etf-unibl/fpga-sonar/docs/rc-servo.md

# Hitec HS-422 Deluxe Standard Servo – Documentation

This document provides detailed information about the **Hitec HS-422 Deluxe Standard Servo**, renowned for its reliability, precision, and durable construction. The servo is widely used in RC models, robotics, and other applications requiring precise position control.

---

HS-422-Servo-Specs__93581
_Picture 1.1_ HS 422 Servo Specification

## 1. Key Characteristics

- **Operating Voltage:**  
  - Operates within a voltage range of **4.8V to 6.0V**, ensuring compatibility with most RC control systems.

- **Speed:**  
  - At **4.8V:** approximately **0.21 seconds/60°** of rotation.
  - At **6.0V:** speed improves to around **0.16 seconds/60°**.

- **Torque:**  
  - At **4.8V:** about **45.82 oz-in** (approximately 3.3 kg-cm).
  - At **6.0V:** up to approximately **56.93 oz-in** (around 4.1 kg-cm).

- **Control System:**  
  - **Analog PWM** – the servo is controlled via a PWM signal with a period of approximately **20 ms** (50 Hz).  
  - The typical operating PWM pulse width ranges between **600 µs** and **2400 µs** (with a center pulse of around 1500 µs).  
  - The servo features a very small **deadband** of about **8 µs**, ensuring high precision.

ser0002_3     
_Picture 1.2_ Shaft position depending on the PWM signal

- **Motor and Mechanical Construction:**  
  - **Motor:** A 3-pole metal brushed motor (often described as a "3-pole metal brush ferrite" motor).
  - **Gears:** Made from **nylon** (a high-efficiency resin gear train) to ensure longevity.
  - **Bearings:** Equipped with dual oilite (lubricated) bushings for excellent centering and stable output shaft performance.

- **Dimensions and Weight:**  
  - **Dimensions (Metric):** 40.6 mm (length) × 19.8 mm (width) × 36.6 mm (height)
  - **Weight:** Approximately **45.5 g** (1.6 oz)

---

## 2. Additional Information

- **Durability and Reliability:**  
  The HS-422 is known for its robust construction. Its dual oilite bushings and high-quality gear train design provide excellent centering and minimal deviation during movement, which is crucial for precise applications.

- **Applications:**  
  The HS-422 is used in:
  - RC models (airplanes, cars, helicopters)
  - Robotics
  - Any application requiring precise angular control and rapid response

- **Modification Options:**  
  With accessories such as a Servo Travel Tuner, the PWM signal range can be expanded, potentially increasing the rotation angle (up to approximately 195° in certain configurations).

- **Technical Documentation:**  
  Detailed datasheets and technical specifications are available from distributors such as DigiKey, RobotShop, ServoDatabase.com, Mr MPX Hobbies, and Sig Manufacturing.

---

zice        
_Picture 1.3_ Servo pinout

## 3. Summary

The **Hitec HS-422 Deluxe Standard Servo** is a reliable analog servo motor operating at **4.8V to 6.0V**, with speeds of **0.21/0.16 sec/60°** and torque ranging from approximately **45.82 oz-in to 56.93 oz-in**. Its robust construction featuring nylon gears, dual oilite bushings, and a 3-pole brushed motor makes it ideal for applications demanding high precision and durability. The servo is controlled via a PWM signal (typically with a 20 ms period) with a very narrow deadband (8 µs), enabling exceptional positional accuracy.

---

## 4. References

- [Servocity – HS-422 Servo-Clockwise (stock)](https://www.servocity.com/hs-422-servo/)
- [ServoDatabase – Hitec HS-422 Deluxe Standard Servo Specifications](https://servodatabase.com/servo/hitec/hs-422)
- [DigiKey HS-422 Servo Datasheet](https://media.digikey.com/pdf/data%20sheets/dfrobot%20pdfs/ser0002_web.pdf)
- [Mr MPX Hobbies – Hitec HS-422 Deluxe Standard Servo](https://mrmpxhobbies.com/product/hitec-hs-422-deluxe-standard-servo/)
- [Sig Manufacturing – HI TECH HS-422 STANDARD SERVO](https://sigmfg.com/products/hi-tech-hs-422-standard-servo)

---

This Markdown documentation provides a comprehensive overview of the Hitec HS-422 Deluxe Standard Servo and serves as a reference for technical and project needs.
