etf-unibl/fpga-sonar/(threads)

Thread 10 (2025-02-03):

Testing RC Servo

Neira7, 2025-02-03:
Potrebno je implementirati osnovni VHDL kod za testiranje RC Servo motora.
Testiranje odziva RC Servo motora na različite PWM signale.

Closed 2025-02-26.

Thread 2 (2025-02-03):

Get Familiar with VUnit Framework

knezicm, 2025-02-03:
The team members are expected to get familiar with the VUnit framework in order to be able to systematically and efficiently verify the design during the project lifetime. The initial instructions on how to setup and use the framework can be found in the link:

https://vunit.github.io/user_guide.html

By the end of the sprint, it is expected to have the following items so that the issue can be considered as completed:

- Documentation page with instructions on how to setup and use VUnit framework that can be used for on-boarding team members who have no experience with the framework. The page can be prepared in form of a Wiki page or as a standalone documentation page placed in the `doc` folder.
- Working example that shows how to integrate a design with corresponding testbench in the project. This example must be reviewed by at least one team member who has not participated in preparing the VUnit instructions and the working example. Moreover, the provided example must pass verification check available in the repository as a GitHub action

Closed 2025-02-17.

Thread 3 (2025-02-03):

Create Module for Controlling VGA Interface

knezicm, 2025-02-03:
Investigate how VGA interface works and create a basic VGA controller for drawing an object on monitor screen. Initial resources you can use to get familiar with the interface are provided on the links below:

https://www.youtube.com/watch?v=5exFKr-JJtg
https://digilent.com/reference/learn/programmable-logic/tutorials/vga-display-congroller/start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

To consider this issue as completed you must achieve at least the following:

- Create a VGA controller which is able to draw a 10x10 pixels red square in the screen center on a white background. You can use standard VGA screen resolution (640x480) or any other which is supported by the monitor.
- Demonstrate the VGA controller operation on DE1-SoC board.

Optionally, if there is time, you can try to accomplish the following:

- Consider possibilities for using other (higher) screen resolutions.
- Try to experiment with drawing multiple objects with different size and color.
- Try to create a testbench, which can be used for the controller verification, and integrate it into the VUnit framework.

Closed 2025-02-12.

Thread 9 (2025-02-03):

Get Familiar with RC Servo

Neira7, 2025-02-03:
Potrebno je upoznati se sa RC Servo motorom:

- Razumijevanje osnovnih principa rada RC Servo motora
- Način kontrole rada RC Servo motora (generisanje i podešavanje PWM signala)
- Povezivanje RC Servo motora sa razvojnom pločom
- Dokumentovati u .md fajl-u

Closed 2025-02-13.

Thread 19 (2025-02-12):

Fixing Issue with Testing the VUnit Framework

rankomirosav, 2025-02-12:

Closed 2025-02-13.

Thread 26 (2025-02-19):

Create a VGA Controller that Draws Colored Zones

Neira7, 2025-02-19:
To consider this issue as completed you must achieve at least the following:

- Create a VGA controller which is able to draw a three circular zones that are represented with different colors (red, yellow,
   green). You can use standard VGA screen resolution (640x480) or any other which is supported by the monitor.
- Demonstrate the VGA controller operation on DE1-SoC board.
- Create a testbench, which can be used for the controller verification, and integrate it into the VUnit framework.

Closed 2025-03-10.

Thread 31 (2025-02-20):

Testing RC Servo Movement for 180 Degrees

radislavkosijer, 2025-02-20:
Task objective:

- Demonstrate the movement of the servo motor from 0 to 180 degrees and back.

- Create testbench, which can be used for RC servo verification, and integrate them into the VUnit framework.

Closed 2025-02-26.

Thread 34 (2025-02-25):

Refactoring RC Servo Module

radislavkosijer, 2025-02-25:
Task objective:

- Separate RC Servo and Controller logic
- Movement of servo is controlled by angle_i
- Controller module generates angle_i
- Create testbench, which can be used for RC servo verification, and integrate them into the VUnit framework.

Neira7, 2025-03-07:
[log.txt](https://github.com/user-attachments/files/19122364/log.txt)

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

Closed 2025-03-10.

Thread 35 (2025-02-26):

Create a Controller for the Ultrasonic Sensor

Chicha13, 2025-02-26:
Create an entity and architecture for the HC-SR04 ultrasonic sensor.

rankomirosav, 2025-03-06:
Dati zahtjev nije moguće sprovesti u cijelosti jer triger i echo signal moraju biti i dio glavnog kontrolera radi fizičkog mapiranja pinova, koji će se onda povezivati za modulom senzora. Stoga su i ti siganli dodani u glavni kontroler.

Thread 41 (2025-03-05):

Test for Ultrasonic Sensor

radislavkosijer, 2025-03-05:
Task objective:
- Create testbench, which can be used for ultrasonic sensor verification
- Integrate it into the VUnit framework

Closed 2025-03-11.

Thread 53 (2025-03-12):

Create Module for Integrating All Modules in One System

radislavkosijer, 2025-03-12:
Task objective:
- Module that enables interaction between VGA, Ultrasonic Sensor and RC Servo modules
- All components are synchronized and work together

Closed 2025-03-17.
