etf-unibl/fpga-sonar/(commit log)

2025-02-13 Issue #9: Get Familiar with RC Servo (#11)
    * Issue #9: Get Familiar with RC Servo
    - Created rc-servo.md file as documentation file for RC Servo
    * Update rc-servo.md
    - Added some informations about RC Servo
2025-02-16 Issue #5 : Creating Documentation for VUnit Framework (#14)
    * Issue #5 : Creating Documentation for VUnit Framework
    Added documentation for VUnit Framework
    * Issue #5 : Creating Documentation for VUnit Framework
    -Added a Test Report screenshot
    * Issue # 5: Creating Documentation for VUnit Framework
    Adding changes to the documentation related to making testbech
    * Issue #5 : Creating Documentation for VUnit Framework
    -Modified documentation
    * Issue #5 : Creating Documentation for VUnit Framework
    -Changed documentation
    ---------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
2025-02-17 Issue #6 : Testing the VUnit Framework (#15)
    * Issue #6 : Testing the VUnit Framework
    Adding test examples for VUnit framework.
    * Issue #16 : Set VUnit docker container to GCC frontend
    * Issue #16 : Comment the old container reference
    * Issue #16 : Fix the workflow file
    * Issue # 19:
    Fixing Issue wit Testing the VUnit Framewor
    Dodavanje izmjena u testbenchu.
    * Issue #16 : Update verif workflow file
    * Issue #6 : Testing t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
2025-02-21 Issue # 27: Creating Documentation for the Ultrasonic Sensor (HC-SR04) (#30)
    * Issue # 27: Creating Documentation for the Ultrasonic Sensor (HC-SR04)
    Adding a Markdown file for the ultrasonic sensor, where the characteristics and mode of operation are given
    * Issue # 27: Creating Documentation for the Ultrasonic Sensor (HC-SR04)
    Adding changes to the ultrasonic sensor documentation.
    * Issue # 27: Creating Documentation for the Ultrasonic Sensor (HC-SR04)
    Adding changes to the ultrasonic sensor documentation.
    * Issue # 27: Creating Documentation for the Ultrasonic Sensor (HC-SR04)
    Adding changes to the ultrasonic sensor documentation.
    * Update hc-sr04.md
    Adding changes to the ultr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
2025-02-26 Issue #28: Create Schematic for Interfacing FPGA Board with the Sensor (#33)
    Create interface_circuit.md as documentation file for interface circuit
2025-03-10 Issue #34: Refactoring RC Servo Module (#36)
    * Issue #34: Refactoring RC Servo Module
    - Added vhdl for servo controller that generates angle
    - Added vhdl for servo that calculates pwm signal for specified angle
    - Added sdc file for pin assigments
    * Issue #34: Refactoring RC Servo Module
    - Corrected mistake in vhdl for controller
    * Issue #34: Refactoring RC Servo Module
    - Corrected mistake in coding standard
    * Issue #40: Test for RC Servo Module (#45)
    - Added testbench file for testing RC Servo module
    ---------
    [rc_servo.vhd, rc_servo_tb.vhd]
2025-03-11 Issue #35: Create a controller for the ultrasonic sensor (#38)
    * Issue #35 : Create a Controller for the Ultrasonic Sensor
    Added file of sensor controller
    * Issue #35 : Create a Controller for the Ultrasonic Sensor
    Changes to the design of sensor controller.
    * Issue #35 : Create a Controller for the Ultrasonic Sensor
    Added sdc fail for sensor controller.
    * Issue #35 : Create a Controller for the Ultrasonic Sensor
    -Added changes to the design
    * Issue #35 : Create a Controller for the Ultrasonic Sensor
    -Split the design into controller and logic parts for purpose of future integration with other modules
    * Issue #35 : Create a Controller for the Ultrasonic Sensor
    -Added new sdc fail.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
    [Ultrasonic_Sensor.vhd, ultrasonic_sensor_tb.vhd]
2025-03-13 Issue #49: Create Diagram Model of Sonar (#52)
    * Issue #49: Create Diagram Model of Sonar
    - Added diagram of system
    - Changed structure of components section
    * Issue #49: Create Diagram Model of Sonar
    - Corrected mistake
    * Issue #49: Create Diagram Model of Sonar
    - Corrected mistake in documentation
2025-03-13 Issue #29: Create VGA Controller Capable of Drawing Dynamic Objects (#39)
    * Issue #29: Create VGA Controller Capable of Drawing Dynamic Objects
    - Added vhdl file for VGA_controller
    - Added vhdl file for draw logic
    - Added sdc file
    * Issue #29: Create VGA Controler Capable of Drawing Dynamic Objects
    - Added a VHDL file for drawing a dynamic object on the screen.
    * Issue #46 : Testing the Drawing of Dynamic Objects in VGA (#54)
    -Added a testbench
    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
    [draw_logic.vhd, vga_controller.vhd, vga_draw_logic_tb.vhd]
2025-03-17 Issue #53: Create Module for Integrating All Modules in One System (#55)
    * Issue #53: Create Module for Integrating All Modules in One System
    - Added vhdl file representing main controller
    - Added sdc file with pin planner
    * Issue #53 : Create Module for Integrating All Modules in One System
    - Added comments and improved coding standards.
    * Issue #53 : Create Module for Integrating All Modules in One System
    - Added comments and improved coding standards.
    * Issue #53 : Create Module for Integrating All Modules in One System
    - Added comments and improved coding standards.
    * Issue 53: Create Module for Intregrating All Modules in One System
    - Restored files
    * Issue 53: Create Module for In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
    [Ultrasonic_Sensor.vhd, draw_logic.vhd, sonar_controller.vhd, sonar_controller_tb.vhd, ultrasonic_sensor_tb.vhd, vga_draw_logic_tb.vhd]
